mwelling/lofive-unchained/design-files/lofive-unchained.kicad_pcb

## KiCad design design-files/lofive-unchained.kicad_pcb (2024-12-01)

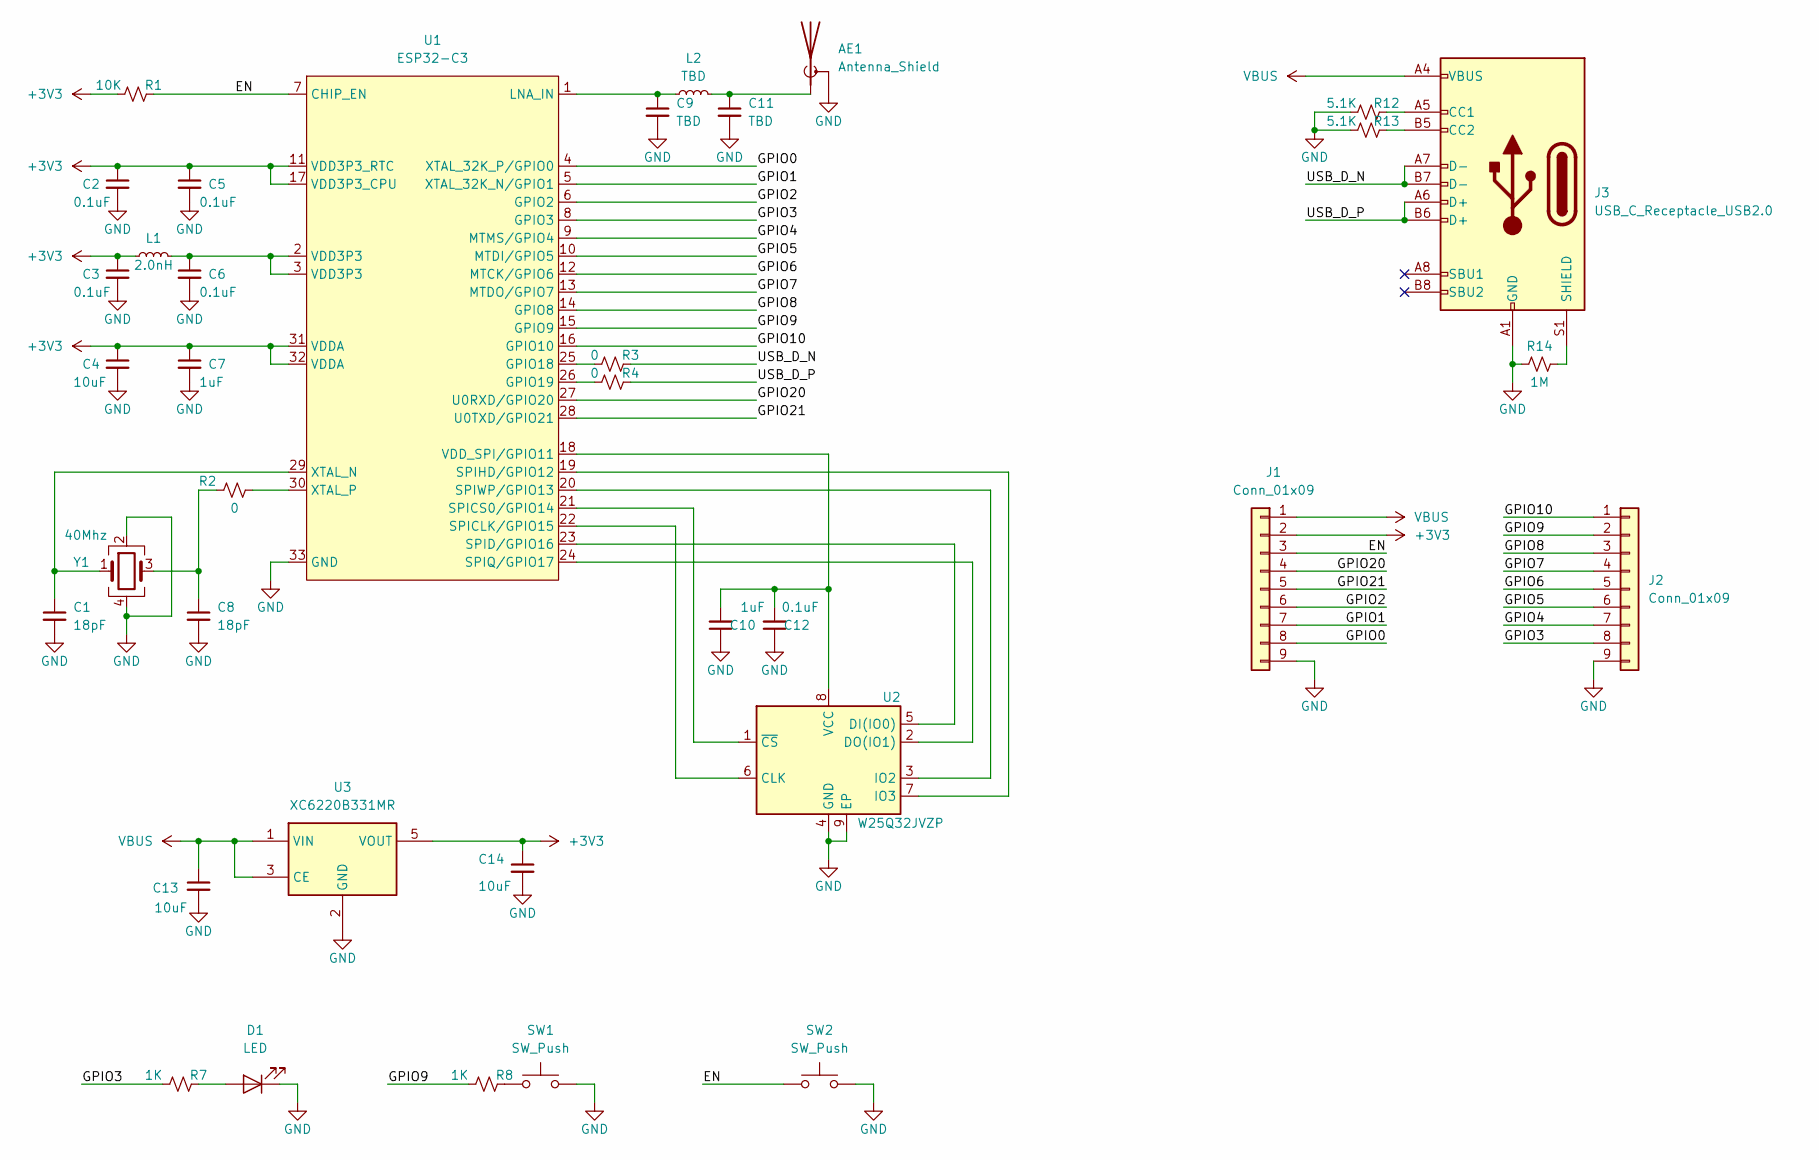
[picture p1: schematic lofive-unchained.kicad_sch]

Parts:
AE1: Antenna_Shield; Texas_SWRA117D_2.4GHz_Left
C1, C8: 18pF; C_0402_1005Metric
C2, C3, C5, C6, C12: 0.1uF; C_0402_1005Metric
C4, C13, C14: 10uF; C_0603_1608Metric
C7, C10: 1uF; C_0402_1005Metric
C9, C11: TBD; C_0402_1005Metric
D1: LED; LED_0603_1608Metric
J1, J2: Conn_01x09; PinHeader_1x09_P2.54mm_Vertical
J3: USB_C_Receptacle_USB2.0; USB_C_Receptacle_HRO_TYPE-C-31-M-12
L1: 2.0nH; L_0402_1005Metric
L2: TBD; L_0402_1005Metric
R1: 10K; R_0402_1005Metric
R2, R3, R4: 0; R_0402_1005Metric
R7, R8: 1K; R_0402_1005Metric
R12, R13: 5.1K; R_0402_1005Metric
R14: 1M; R_0402_1005Metric
SW1, SW2: SW_Push; SW_Push_1P1T_NO_CK_KMR2
U1: ESP32-C3; QFN-32-1EP_5x5mm_P0.5mm_EP3.6x3.6mm
U2: W25Q32JVZP; WSON-8-1EP_6x5mm_P1.27mm_EP3.4x4.3mm
U3: XC6220B331MR; SOT-23-5
Y1: 40Mhz; Crystal_SMD_2520-4Pin_2.5x2.0mm

Connections:
+3V3: C2.1, C3.1, C4.1, C5.1, C7.1, C14.1, J1.2, L1.1, R1.1, U1.11 (VDD3P3_RTC), U1.17 (VDD3P3_CPU), U1.31 (VDDA), U1.32 (VDDA), U3.5 (VOUT)
/EN: J1.3, R1.2, SW2.1, U1.7 (CHIP_EN)
/GPIO0: J1.8, U1.4 (XTAL_32K_P/GPIO0)
/GPIO1: J1.7, U1.5 (XTAL_32K_N/GPIO1)
/GPIO2: J1.6, U1.6 (GPIO2)
/GPIO3: J2.8, R7.1, U1.8 (GPIO3)
/GPIO4: J2.7, U1.9 (MTMS/GPIO4)
/GPIO5: J2.6, U1.10 (MTDI/GPIO5)
/GPIO6: J2.5, U1.12 (MTCK/GPIO6)
/GPIO7: J2.4, U1.13 (MTDO/GPIO7)
/GPIO8: J2.3, U1.14 (GPIO8)
/GPIO9: J2.2, R8.1, U1.15 (GPIO9)
/GPIO10: J2.1, U1.16 (GPIO10)
/GPIO20: J1.4, U1.27 (U0RXD/GPIO20)
/GPIO21: J1.5, U1.28 (U0TXD/GPIO21)
/USB_D_N: J3.A7 (D-), J3.B7 (D-), R3.2
/USB_D_P: J3.A6 (D+), J3.B6 (D+), R4.2
GND: AE1.2 (Shield), C1.2, C2.2, C3.2, C4.2, C5.2, C6.2, C7.2, C8.2, C9.2, C10.1, C11.2, C12.1, C13.2, C14.2, D1.1 (K), J1.9, J2.9, J3.A1 (GND), J3.A12 (GND), J3.B1 (GND), J3.B12 (GND), R12.1, R13.1, R14.1, SW1.2, SW2.2, U1.33 (GND), U2.4 (GND), U2.9 (EP), U3.2 (GND), Y1.2, Y1.4
unnamed: AE1.1 (A), C11.1, L2.2
unnamed: C6.1, L1.2, U1.2 (VDD3P3), U1.3 (VDD3P3)
unnamed: C8.1, R2.1, Y1.3
unnamed: D1.2 (A), R7.2
unnamed: J3.A5 (CC1), R12.2
unnamed: J3.B5 (CC2), R13.2
unnamed: J3.S1 (SHIELD), R14.2
unnamed: R8.2, SW1.1
unnamed: R3.1, U1.25 (GPIO18)
unnamed: R4.1, U1.26 (GPIO19)
unnamed: C9.1, L2.1, U1.1 (LNA_IN)
unnamed: U1.22 (SPICLK/GPIO15), U2.6 (CLK)
unnamed: U1.21 (SPICS0/GPIO14), U2.1 (~CS)
unnamed: U1.23 (SPID/GPIO16), U2.5 (DI(IO0))
unnamed: U1.19 (SPIHD/GPIO12), U2.7 (IO3)
unnamed: U1.24 (SPIQ/GPIO17), U2.2 (DO(IO1))
unnamed: U1.20 (SPIWP/GPIO13), U2.3 (IO2)
unnamed: C10.2, C12.2, U1.18 (VDD_SPI/GPIO11), U2.8 (VCC)
unnamed: C1.1, U1.29 (XTAL_N), Y1.1
unnamed: R2.2, U1.30 (XTAL_P)
VBUS: C13.1, J1.1, J3.A4 (VBUS), J3.A9 (VBUS), J3.B4 (VBUS), J3.B9 (VBUS), U3.1 (VIN), U3.3 (CE)

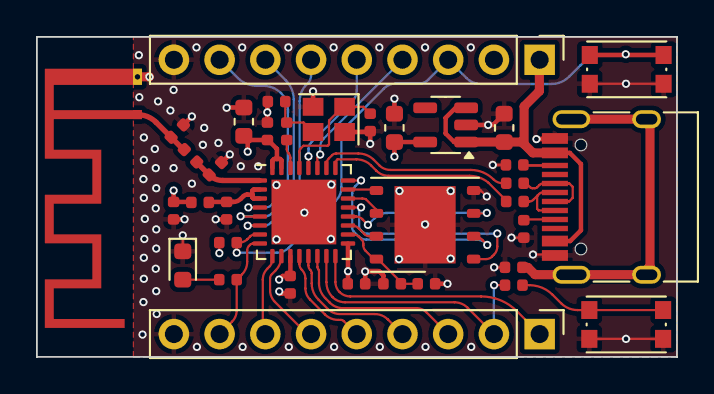
[picture p2: board lofive-unchained.kicad_pcb from above]

Board: 4 copper layers, 35.6 x 17.8 mm, 36 parts (0 on the bottom side), 39 nets.
