mwelling/lofive-unchained/(threads)

Thread 1 (2024-12-01):

3.3V switcher is not working

mwelling, 2024-12-01:
Switching regulator is messed up. Combined passive and layout issues.

mwelling, 2024-12-01:
Switched to LDO.

Closed 2024-12-01.
