mwelling/lofive-unchained/(commit log)

2021-12-15 Initial commit of design files
    [lofive-unchained.kicad_pcb, lofive-unchained.kicad_sch]
2021-12-15 Rename folder with design files
    [lofive-unchained.kicad_pcb, lofive-unchained.kicad_sch]
2021-12-21 Preliminary routing complete
    Need to check the RF trace and USB routing.
    [lofive-unchained.kicad_pcb]
2021-12-21 Update minimum hole size
    Get rid of a bunch of DRC errors.
2021-12-22 Switch to HRO USB connector
    Available at LCSC.
    [lofive-unchained.csv, lofive-unchained.kicad_pcb, lofive-unchained.kicad_sch]
2022-01-13 Add consummate vias and plot
    [lofive-unchained-B_Cu.gbr, lofive-unchained-B_Mask.gbr, lofive-unchained-B_Paste.gbr, lofive-unchained-B_Silkscreen.gbr, lofive-unchained-Edge_Cuts.gbr, lofive-unchained-F_Cu.gbr, lofive-unchained-F_Mask.gbr, lofive-unchained-F_Paste.gbr]
2022-02-01 Post ibom and gerber zip
2024-12-01 Switch to 3.3V LDO instead of switcher
    [lofive-unchained.kicad_pcb, lofive-unchained.kicad_sch]
